EoghanODuffy/RiverGauge/river-gauge-schematic.png

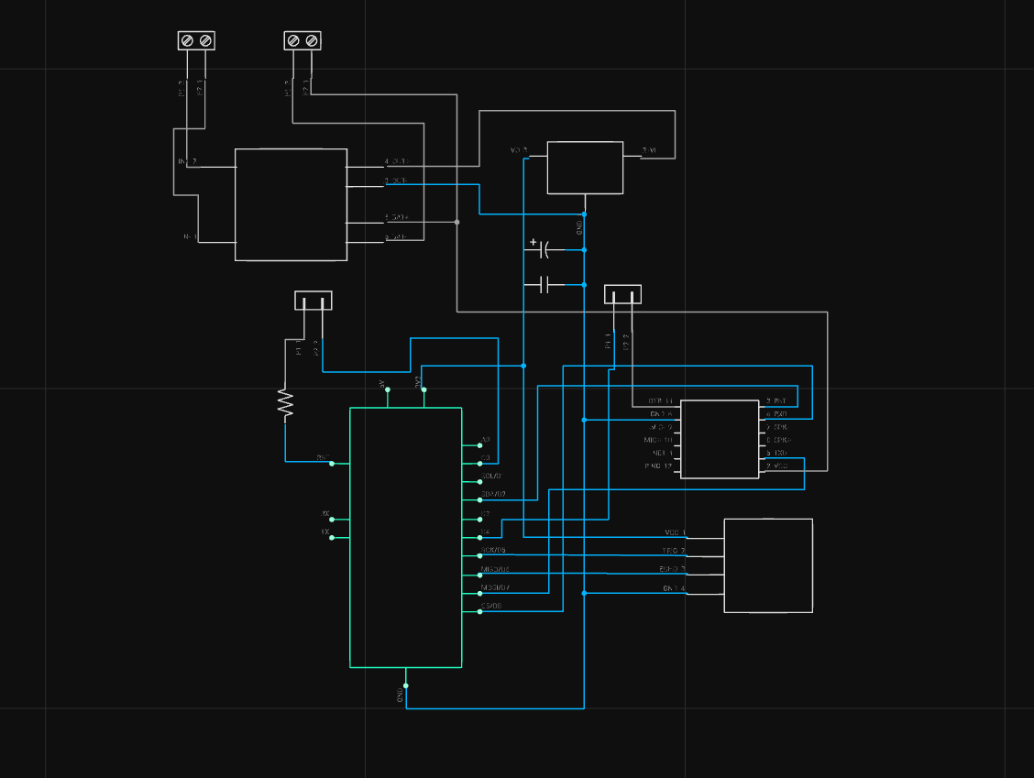
river-gauge-schematic.png
