EoghanODuffy/RiverGauge/Bill of Materials.xlsx

 |  |  |  |  | Total Cost | £28.40
Part | Details | Quantity | Link | Pack of | Price for pack | price for 1 module
PCB |  | 1 | pcbway | 10 | £14.00 | £1.40
D1 Mini | ESP2866 | 1 | https://www.aliexpress.com/item/1005005121150737.html?curPageLogUid=O6Kp0jqM2J5j | 10 | £25.00 | £2.50
Ultrasonic Sensor | JSN-Sr04T / AJ-SR04M | 1 | https://www.aliexpress.com/item/1005005995118143.html?curPageLogUid=OfX7FENfq1dG | 1 | £3.60 | £3.60
Sim Module | Sim800l small red board 3.3v | 1 | https://www.aliexpress.com/item/1005006003979452.html?curPageLogUid=E0cN7pFpKOLP | 1 | £4.08 | £4.08
Charge Module | TP4056 | 1 | https://www.aliexpress.com/item/1005006079406026.html?curPageLogUid=o5uJADcrA6GI | 10 | £4.41 | £0.44
Solar Panel | 80*80 6v 0.9w | 1 | https://www.aliexpress.com/item/1005004689060279.html?curPageLogUid=EAxV2bP6CyQm | 1 | £2.50 | £2.50
Screw Terminal Block | 2 way | 2 | https://www.aliexpress.com/item/1005003373535370.html?curPageLogUid=aSjnFQiTxlCm | 20 | £2.00 | £0.20
LDO Linear Voltage Regulator | HT7333-A | 1 | https://www.aliexpress.com/item/1005005303869447.html?curPageLogUid=2x4v1OdJ9UxW | 10 | £1.40 | £0.14
Resistor | 510 ohm | 1 | https://www.aliexpress.com/item/4001196968633.html?curPageLogUid=LeLEt1SAtDfW | 50 | £2.00 | £0.04
Capacitor | 10V 1000uF | 1 | https://www.aliexpress.com/item/1005005945738204.html?curPageLogUid=XW5px9MAcDe0 | 10 | £2.80 | £0.28
Capacitor | 100nF | 1 | https://www.aliexpress.com/item/32973259342.html?curPageLogUid=Pibu00k7zZ3W | 100 | £2.00 | £0.02
Jumpers | dupont style | 2 | https://www.aliexpress.com/item/10000002338839.html?curPageLogUid=XKoIrwUNeIJG | 100 | £2.00 | £0.04
Pin Headers | 10 pins (to be cut) | 1 | https://www.aliexpress.com/item/32758380907.html?curPageLogUid=2BFsrIL63JZz | 40 | £2.00 | £0.05
Wire | Black and Red 20cm approx? | 1 | https://www.aliexpress.com/item/4000689875049.html?curPageLogUid=pnlcWFtWUaKn | 25 | £2.84 | £0.11
Battery | 18650 | 2 |  | 10 | £15.00 | £3.00
Battery Holder | for 18650 | 1 |  | 1 | £2.00 | £2.00
Sim Card | simbase | 1 |  | 1 | £8.00 | £8.00
