EoghanODuffy/RiverGauge/(list of files, drawings)

Other design files:
PCB/EasyEDAPro_River Gauge Rev 2_2026-01-11.epro
