EoghanODuffy/RiverGauge/(commit log)

2024-01-08 Update README.md
    Add assembled pcb image
2024-03-05 Add files via upload
    New PCB design which uses a mosfet to switch on and off the SIM800l module to improve battery life. This should allow for up to 21 days of no sun instead of only 7
2024-03-16 Update ESP8266_River_Gauge_V1-0.ino
    Sim800l shutdown with mosfet instead of sleeping
    Longer sleep intervals when battery is running low
2025-11-15 Update ESP8266_River_Gauge_V1-2.ino
    Bug fixes, bit of tidy up and removed some redundant code. Still plenty more to do
    [ESP8266_River_Gauge_V1-2.ino]
2025-11-15 Update ESP8266_River_Gauge_V1-2.ino
    Bug Fixes
    Updated webserver link
    Removed redundant code
    still plenty of cleaning up to do
    [ESP8266_River_Gauge_V1-2.ino]
2026-01-11 Added Rev2 PCB design
    This is a new revision designed to work with LiFePO4 batteries for better safety and cold weater performance
    Microcontroller has also been updated to an ESP32 S2 Mini by Wemos
    [EasyEDAPro_River Gauge Rev 2_2026-01-11.epro]
